NiklausHofer/suniversal/suniversal/macros.cpp

/*
    macros - macro definitions for special keys
    Copyright (c) 2017, Alexander Vollschwitz

    This file is part of suniversal.

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
    You should have received a copy of the GNU General Public License
    along with suniversal. If not, see <http://www.gnu.org/licenses/>.
 */

#include "config.h"
#include "macros.h"

// individual macros
static const uint16_t macro_again[]   = {CONTROL, USB_Y, 0};
static const uint16_t macro_undo[]    = {CONTROL, USB_Z, 0};
static const uint16_t macro_undo_fr[] = {CONTROL, USB_W, 0};
static const uint16_t macro_copy[]    = {CONTROL, USB_C, 0};
static const uint16_t macro_paste[]   = {CONTROL, USB_V, 0};
static const uint16_t macro_cut[]     = {CONTROL, USB_X, 0};

static const uint16_t macro_stop[]    = {CONTROL, USB_SYSRQ, 0};
static const uint16_t macro_props[]   = {ALT, USB_ENTER, 0};
static const uint16_t macro_front[]   = {ALT, USB_TAB, 0};
static const uint16_t macro_open[]    = {CONTROL, USB_O, 0};
static const uint16_t macro_find[]    = {CONTROL, USB_F, 0};

static const uint16_t macro_help[]    = {ALT, USB_H, 0};
//

MacroTable::MacroTable() {
    DPRINTLN("populating macro table");
    table[MACRO_AGAIN] = macro_again;
    table[MACRO_UNDO]  = macro_undo;
    table[MACRO_COPY]  = macro_copy;
    table[MACRO_PASTE] = macro_paste;
    table[MACRO_CUT]   = macro_cut;
    table[MACRO_STOP]  = macro_stop;
    table[MACRO_PROPS] = macro_props;
    table[MACRO_FRONT] = macro_front;
    table[MACRO_OPEN]  = macro_open;
    table[MACRO_FIND]  = macro_find;
    table[MACRO_HELP]  = macro_help;
}

uint16_t* MacroTable::get(uint8_t ix) {
    return table[ix];
}

/*
    For the different keyboard layouts see:
        https://docs.oracle.com/cd/E19683-01/806-6642/new-357/index.html
 */
MacroTable::adjustToLayout(uint8_t layout) {
    switch (layout) {
        case FRENCH_BELGIUM:
            DPRINTLN("adjusting macro for French/Belgium layout");
            table[MACRO_UNDO] = macro_undo_fr;
            break;

        case GERMANY:
        case SWISS_FRENCH:
        case SWISS_GERMAN:
            DPRINTLN("adjusting macro for German/Swiss layout");
            table[MACRO_AGAIN] = macro_undo;
            table[MACRO_UNDO] = macro_again;
            break;
/*
    currently, nothing to do for these layouts

        case CANADA_FRENCH:
        case DENMARK:
        case ITALY:
        case NETHERLANDS:
        case NORWAY:
        case PORTUGAL:
        case SPAIN_LATIN_AMERICA:
        case SWEDEN_FINLAND:
        case UNITED_KINGDOM:
            break;
 */
        default:
            break;
    }
}
