NiklausHofer/suniversal/(commit log)

2017-12-24 doc update, connector image
2017-12-30 compared key codes to SUN Type 7 keyboard & corrected accordingly
    [sun_to_usb.h]
2018-01-14 switch to NicoHood's HID lib; boot protocol & LED control by host now suppoerted
2018-04-09 fixed mouse protocol detection
    [mouse.cpp, mouse.h]
2018-04-12 mouse wheel emulation; refactoring
